jbu5105/Midi_synth/README.md

# Midi_synth
Analog &amp; Digital MIDI synth based on analog circuitry and LaunchPad conectada TM4C1294 with an ARM microcontroller.

All the documentation of the project it is gathered in the pdf file
